pixmusix/Tinyi2cMsgEq7/schematics/Schematic Basic.jpg

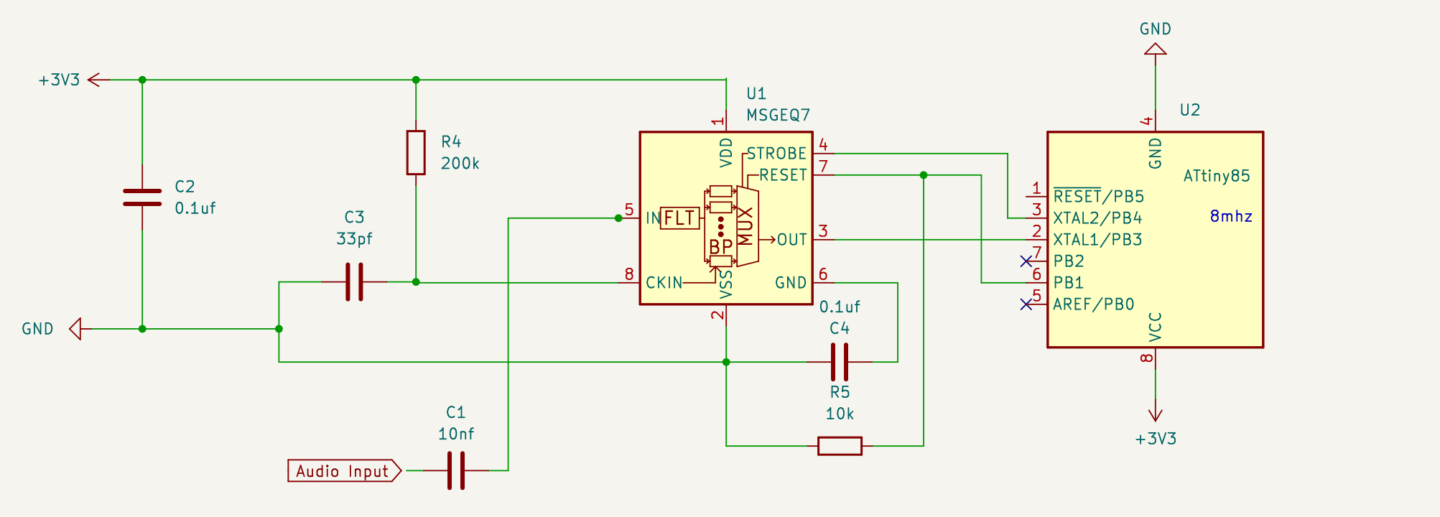
schematics/Schematic Basic.jpg
