pixmusix/Tinyi2cMsgEq7/schematics/BOM.md

# BOM

### Chips

- [AtTiny85 Mircoprocessor](https://core-electronics.com.au/avr-8-pin-20mhz-8k-4a-d-attiny85.html)
- [MSI's MsgEq7](https://core-electronics.com.au/graphic-equalizer-display-filter-msgeq7.html)

### Connectors

- [TRS Breadboard Jack](https://core-electronics.com.au/breadboard-friendly-3-5mm-stereo-headphone-jack.html)
- [Piicodev Adapter](https://core-electronics.com.au/piicodev-breadboard-adapter.html)

### Board

- [Makerverse 30 breadboard](https://core-electronics.com.au/makerverse-protoboard-30-row.html)
- [4x M3 plastic screws and spacer](https://core-electronics.com.au/makerverse-m3-mounting-kit.html)

### Components

##### Resistors
- 4 * 10kΩ
- 2 * 4.6kΩ
- 2 * 5.6kΩ
- 1 * 26kΩ
- 1 * 200kΩ

##### Capacitors
- 1 * 33pf
- 1 * 10nf
- 3 * 0.1uf
