pixmusix/Tinyi2cMsgEq7/TinyWireMSGEQ7/i2cMessage.h

struct i2cMessage {
  byte lsb;
  byte msb;
};

i2cMessage makei2cMsg(byte msb, byte lsb) {
  i2cMessage msg;
  msg.msb = msb;
  msg.lsb = lsb;
  return msg;
}

class i2cBuffer {

  /* a circular buffer for i2cMessages 
     no overflow protection provided */

  protected:
    static const int bufSize = 128;
    i2cMessage postables[bufSize];
    int writeMark;                   // position in postables to write 
    int readMark;                    // position is postables to read

  public:

    i2cBuffer() {
      writeMark = 0;
      readMark = 0;
    }

    bool isEmpty() {
      return (readMark == writeMark);
    };

    void add(i2cMessage msg) {
      postables[writeMark] = msg;
      writeMark = incrementMarker(writeMark);
    }

    i2cMessage getNext() {
      i2cMessage msg = postables[readMark];
      readMark = incrementMarker(readMark);
      return msg;
    } 

    int incrementMarker(int mark) {
      mark = mark + 1;
      mark = mark % bufSize;
      return mark;
    }
};
