pixmusix/Tinyi2cMsgEq7/(commit log)

2024-11-07 Added test code in examples. Moved Schematics to their own folder. Added test audio to assets.
2024-11-12 added links to BOM
